Ethan8Robson/Ewiepad/pcb/README.md

# PCB
## This section was created in honor of Daniel
### Front View

### Back View

### Ordering the PCB
To order the PCB, take the .zip file and upload it to your favorite PCB manufacturer. I used JLCpcb.
