Ethan8Robson/Ewiepad/case/README.md

# The Case
ewiepad exploded view
Made using Onshape
<br> The top and bottom parts are attached together via 2 screws on the sides of the case
