Ethan8Robson/Ewiepad/case/ewiepad bottom.step

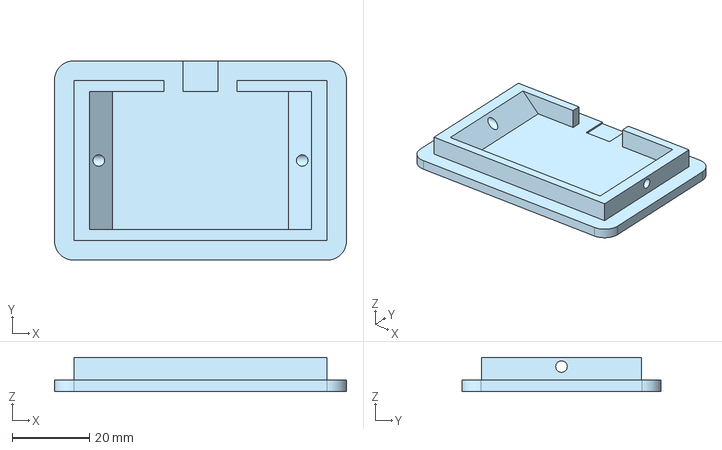
[picture p1: CAD file, 2021-09-12]
case/ewiepad bottom.step
75.8 x 51.8 x 8.90 mm
