Ethan8Robson/Ewiepad/pcb/gerber/ewiepad.step

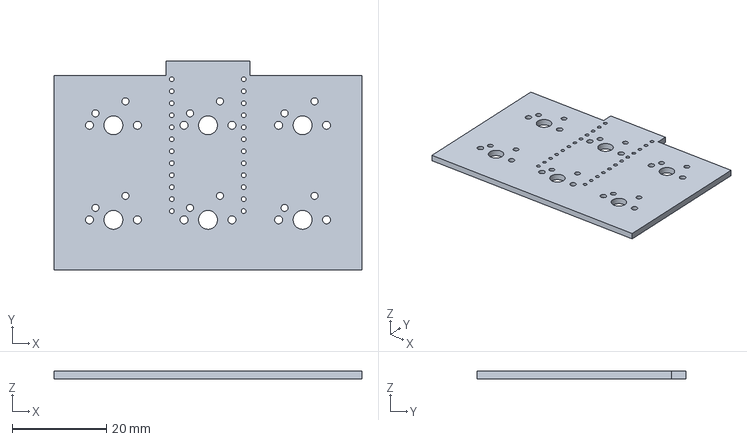
[picture p2: CAD file, 2021-09-12]
pcb/gerber/ewiepad.step
65.3 x 44.3 x 1.60 mm
