Ethan8Robson/Ewiepad/case/ewiepad top.step

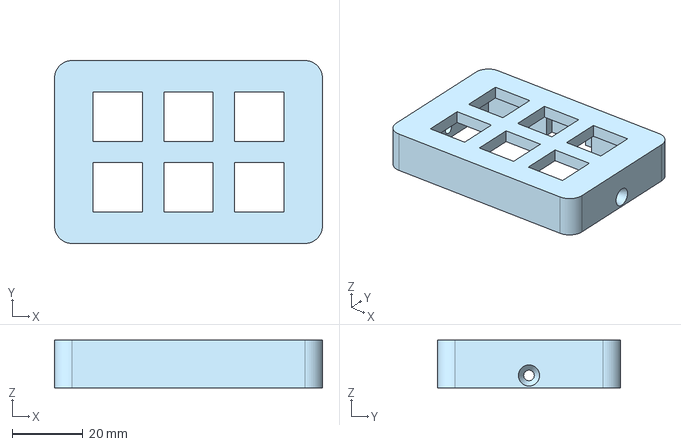
[picture p3: CAD file, 2021-09-12]
case/ewiepad top.step
75.8 x 51.8 x 13.5 mm
