Ethan8Robson/Ewiepad/(list of files, cad)

Other CAD files:
case/ewiepad bottom.stl
case/ewiepad top.stl
