Ethan8Robson/Ewiepad/pcb/schematic.pdf

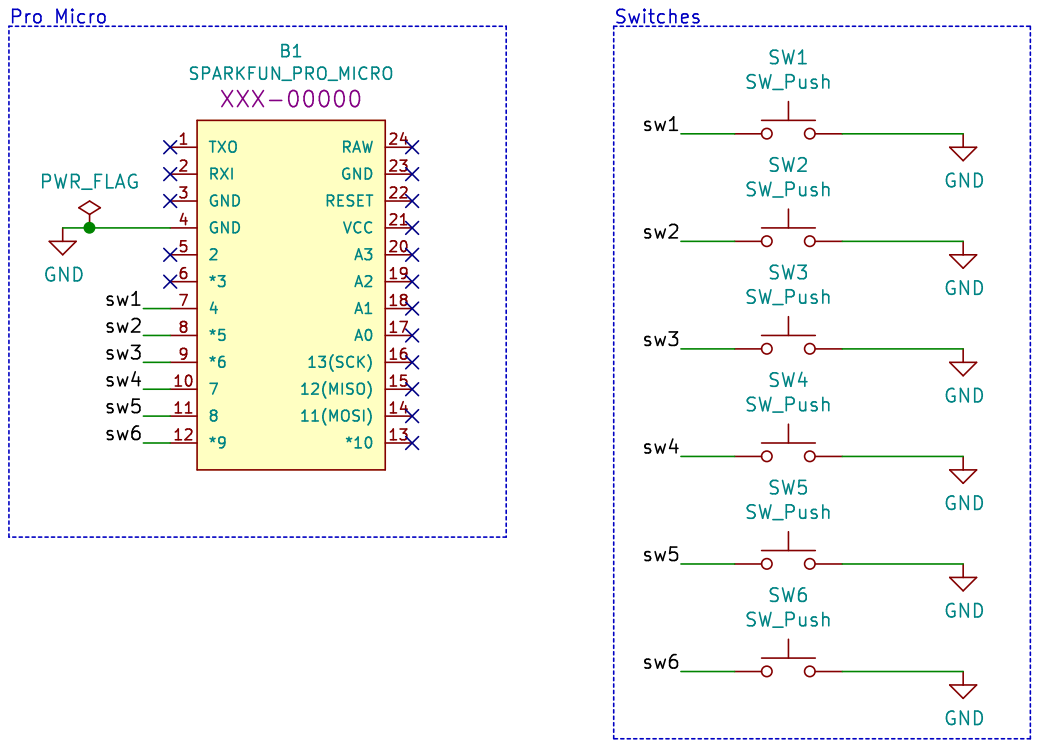
[picture p4: page 1]
