Ethan8Robson/Ewiepad/pcb/gerber/ewiepad.kicad_pcb

## KiCad design pcb/gerber/ewiepad.kicad_pcb (2021-09-12)

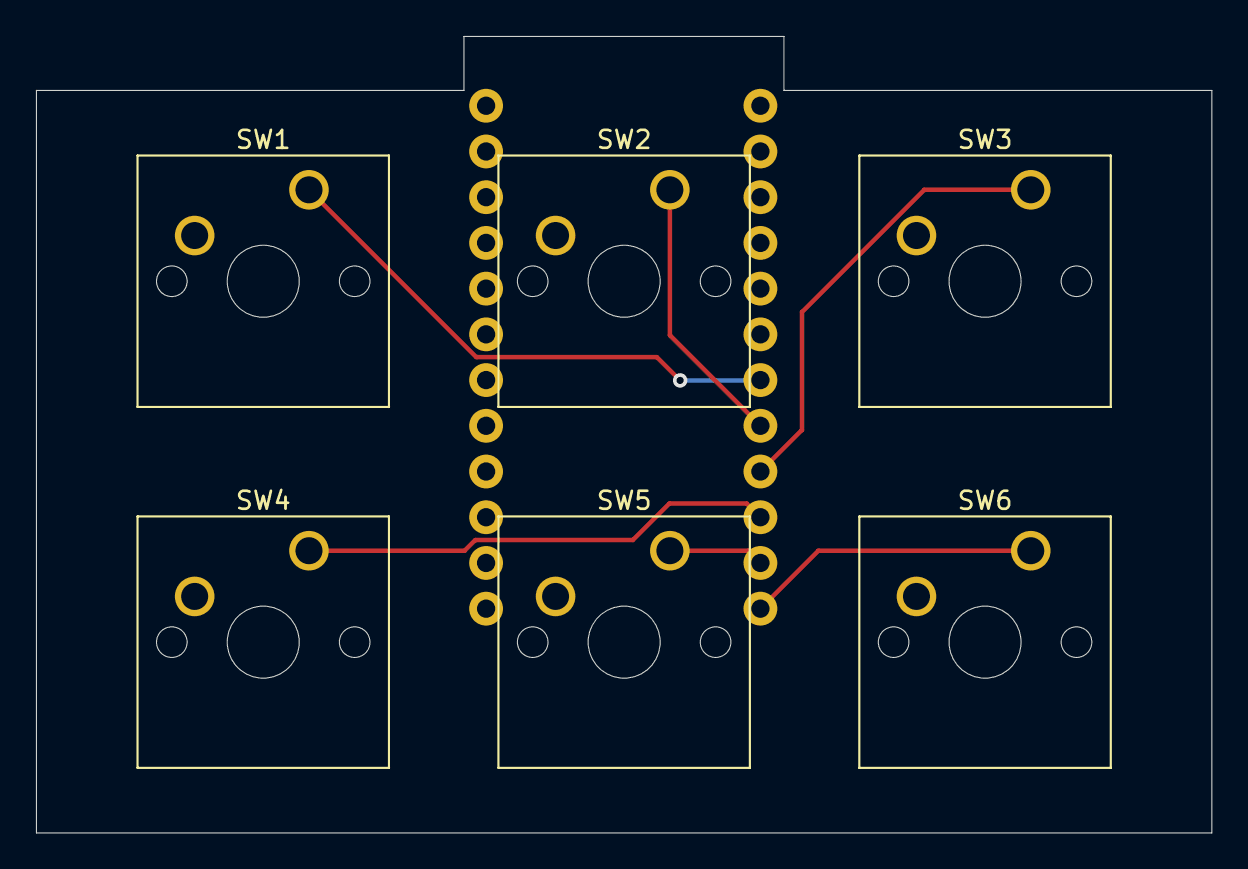
[picture p5: board ewiepad.kicad_pcb from above]

Board: 2 copper layers, 65.3 x 44.3 mm, 7 parts (1 on the bottom side), 7 nets.

Parts:
B1: SPARKFUN_PRO_MICRO
SW1, SW2, SW3, SW4, SW5, SW6: SW_Push; SW_Cherry_MX_1.00u_PCB

Connections:
/sw1: B1.7, SW1.1
/sw2: B1.8, SW2.1
/sw3: B1.9, SW3.1
/sw4: B1.10, SW4.1
/sw5: B1.11, SW5.1
/sw6: B1.12, SW6.1
GND: B1.4, SW1.2, SW2.2, SW3.2, SW4.2, SW5.2, SW6.2
