Ethan8Robson/Ewiepad/(commit log)

2021-09-12 Add case files
    [ewiepad bottom.step, ewiepad bottom.stl, ewiepad top.step, ewiepad top.stl]
2021-09-12 Create Ewiepad case.md
2021-09-12 Rename Ewiepad case.md to README.md
2021-09-12 Add pcb files
    [ewiepad.kicad_pcb, ewiepad.sch, ewiepad.step]
